aaloraini/portable-vending-machine/hardware/electronics/Electronics Sch.png

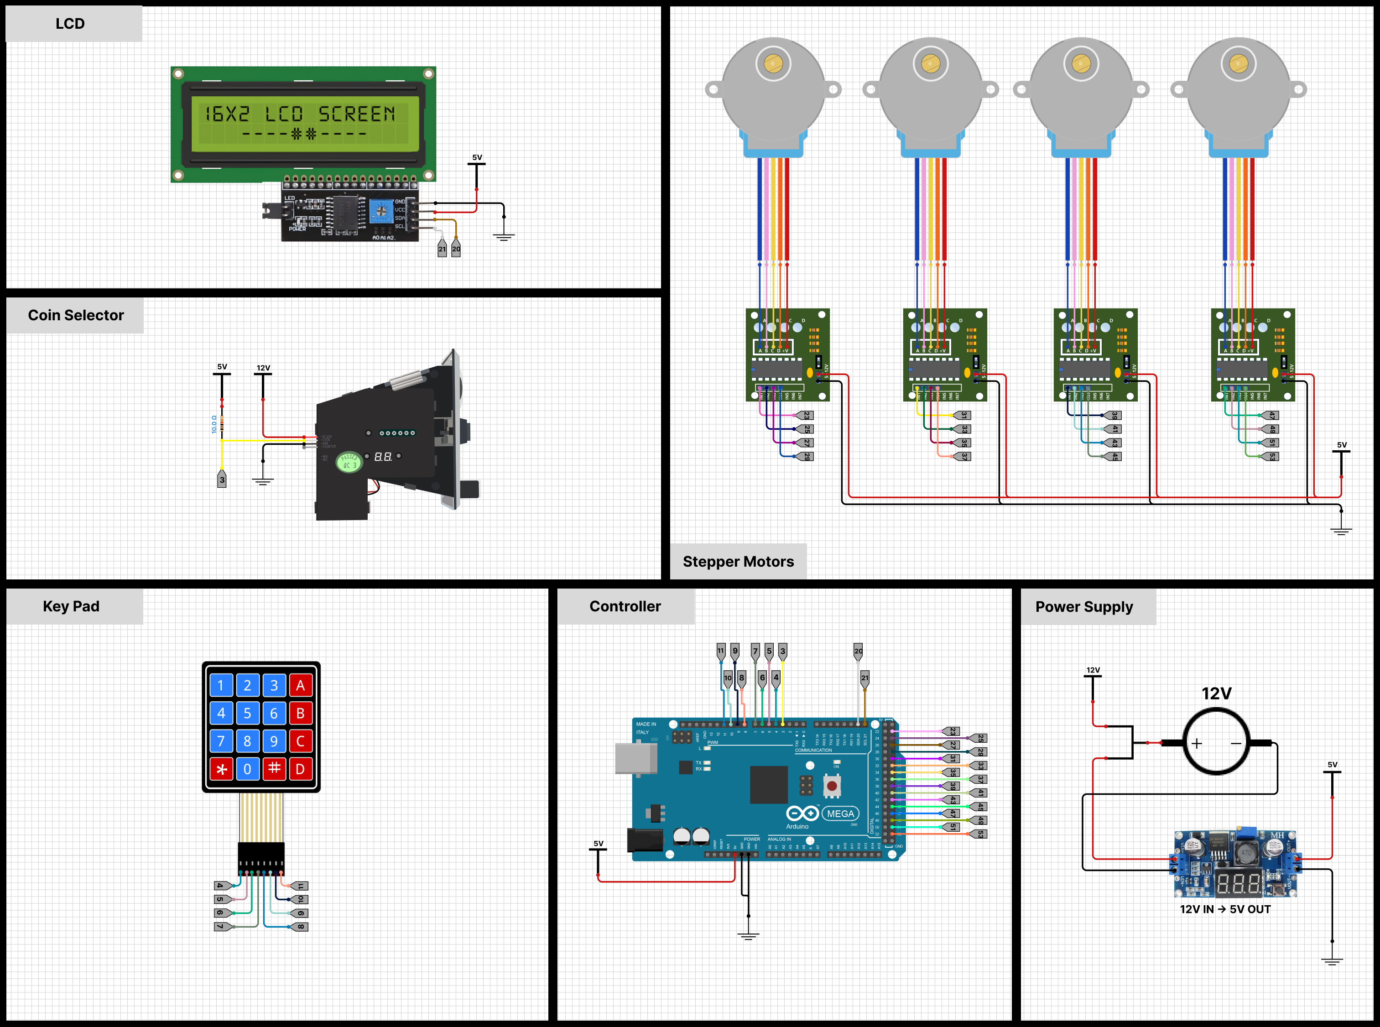
hardware/electronics/Electronics Sch.png
