aaloraini/portable-vending-machine/hardware/electronics/Demo BOM.xlsx

Product Name | X | Y | Z | DataSheet
Arduino Mega 2560 Rev3 | 100.5mm | 53mm | 14.05mm | Arduino Mega 2560 Rev3 (https://docs.arduino.cc/resources/datasheets/A000067-datasheet.pdf)
LCD Display (1602A QAPASS) | 80+-0.5mm | 36+-0.5mm | 17+-0.5mm | LCD Display (1602A QAPASS) (https://funduino.de/DL/1602LCD.pdf)
(1602A QAPASS) Front Display | 71+-0.5mm | 24+-0.5mm | 4.5+-0.5mm | LCD Display (1602A QAPASS) (https://funduino.de/DL/1602LCD.pdf)
Full Sized breadboard | 170mm | 55mm | 10mm | Breadboard (https://media.digikey.com/pdf/Data%20Sheets/Adafruit%20PDFs/239_Web.pdf)
(28BYJ-48 ) Stepper mototr | 28mm | 31mm | 29+-0.5mm | (28BYJ-48 ) Stepper mototr (https://www.gentiam.com/wp-content/uploads/2022/09/GentiamElectronics-28BYJ-48-Stepper-Motor-Datasheet-Rev20220925-final.pdf)
ULN2003 Driver | 35mm | 32.5mm | 13mm | ULN2003 Driver (https://www.hadex.cz/spec/m513.pdf)
Keypad | 69mm | 76mm | __ | Keypad (https://cdn.sparkfun.com/assets/f/f/a/5/0/DS-16038.pdf)
Keypad Cable | 20mm | 88mm | __ | Keypad (https://cdn.sparkfun.com/assets/f/f/a/5/0/DS-16038.pdf)
SW616 Coin Acceptor | 64mm | 124mm | 143mm | SW616 Coin Acceptor (https://probots.co.in/technical_data/Probots616CoinAcceptorModuleDatasheet.pdf)
