aaloraini/portable-vending-machine/hardware/cad/Vending Machine Layouts.pdf

297

297

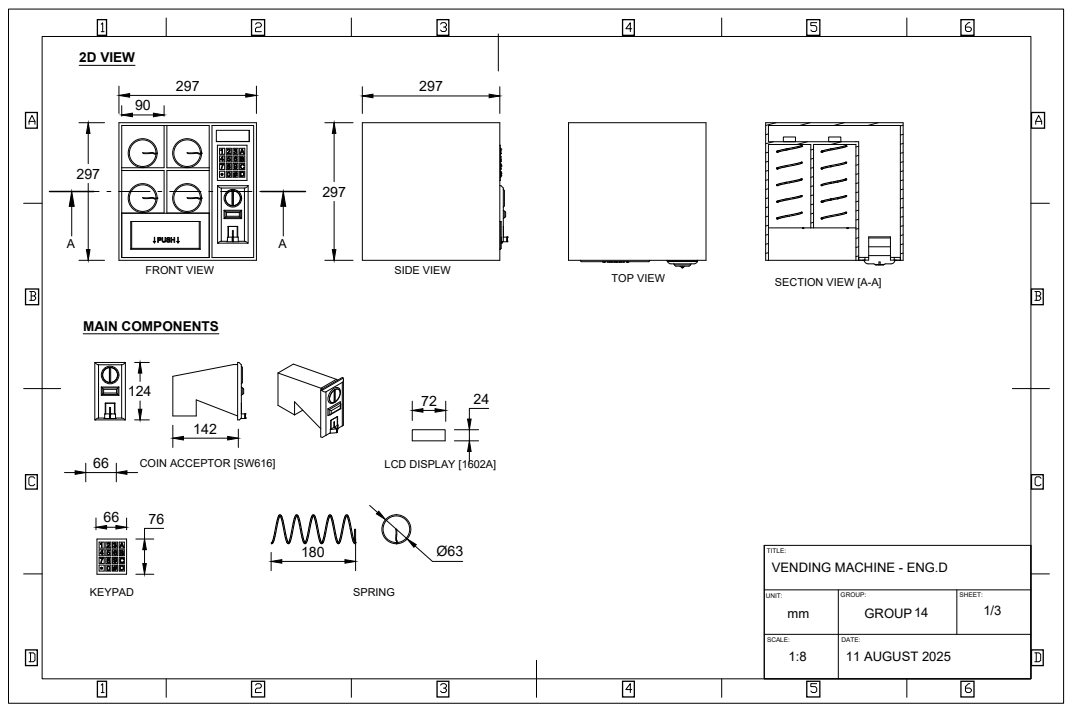
[picture p2: page 1]
FRONT VIEW; SIDE VIEW; TOP VIEW; 2D VIEW; MAIN COMPONENTS; COIN ACCEPTOR [SW616]; KEYPAD; SPRING; LCD DISPLAY [1602A]; UNIT:; SCALE: 1:8; GROUP: GROUP14; DATE: 11 AUGUST 2025; SHEET:; SECTION VIEW [A-A]

TITLE:
VENDING MACHINE - ENG.D

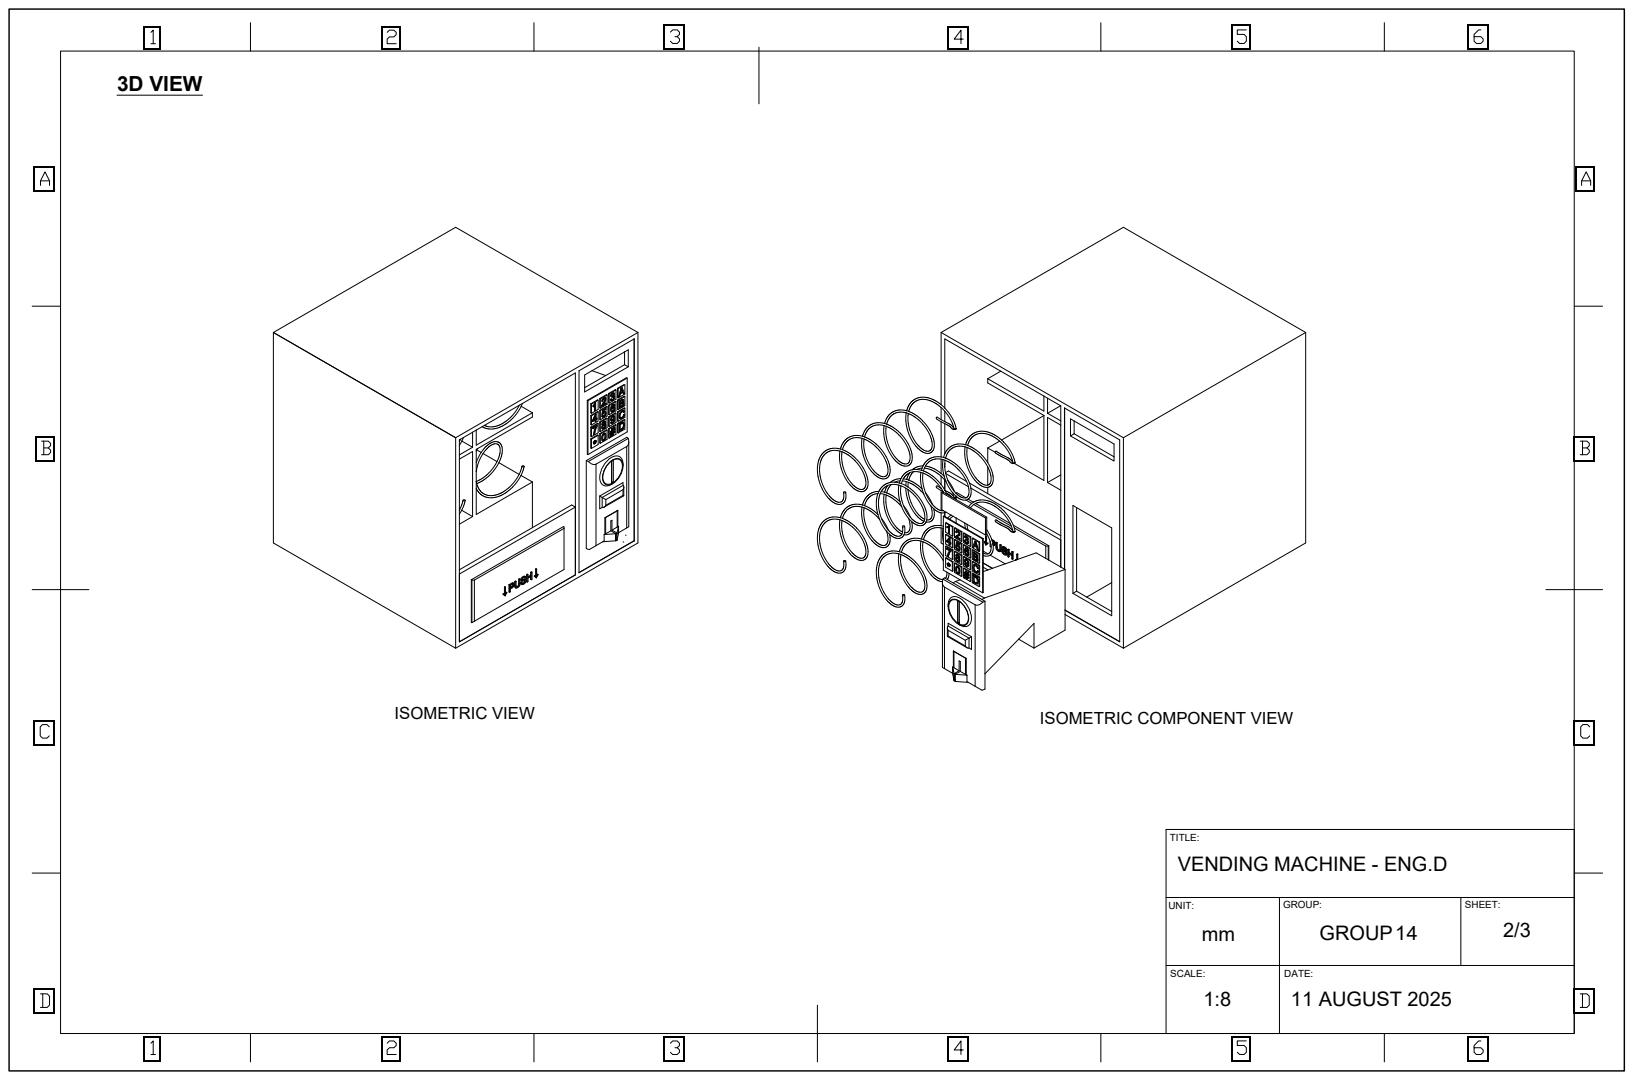
[picture p3: page 2]
3D VIEW; ISOMETRIC VIEW; ISOMETRIC COMPONENT VIEW; UNIT:; SCALE: 1:8; GROUP: GROUP14; DATE: 11 AUGUST 2025; SHEET:

TITLE:
VENDING MACHINE - ENG.D

285

297

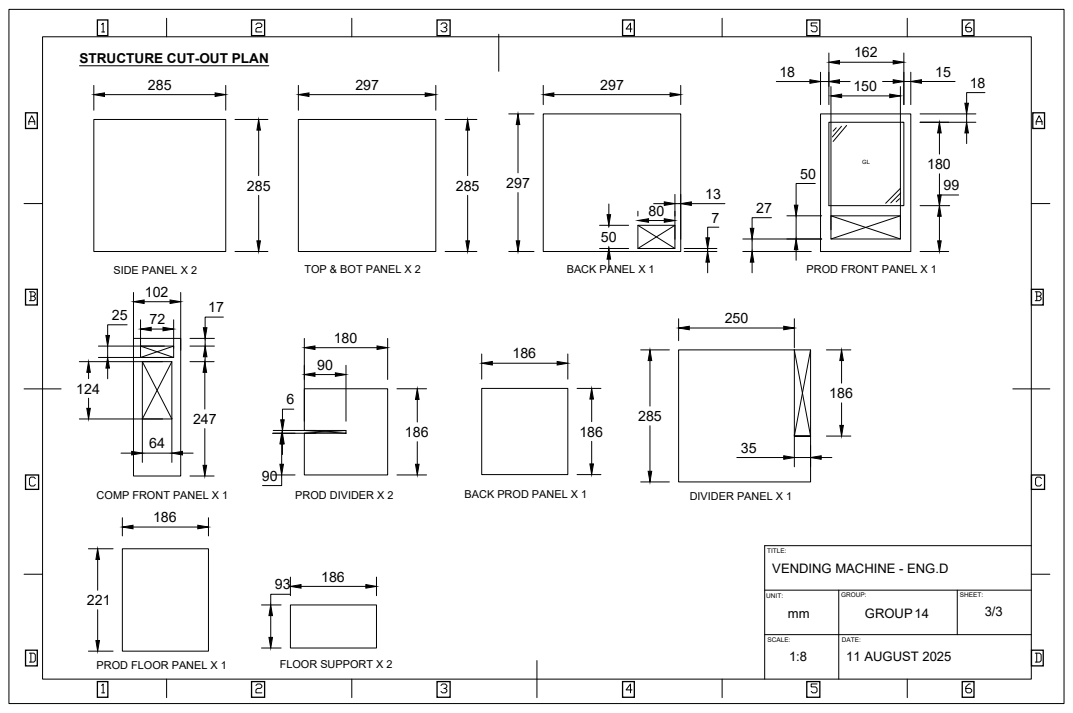
[picture p4: page 3]
SIDE PANEL X 2; BACK PANEL X 1; PROD DIVIDER X 2; DIVIDER PANEL X 1; FLOOR SUPPORT X 2; UNIT:; SCALE: 1:8; GROUP: GROUP14; DATE: 11 AUGUST 2025; SHEET:

STRUCTURE CUT-OUT PLAN

TOP & BOT PANEL X 2

PROD FRONT PANEL X 1

COMP FRONT PANEL X 1

BACK PROD PANEL X 1

TITLE:
VENDING MACHINE - ENG.D

PROD FLOOR PANEL X 1
