aaloraini/portable-vending-machine/logic/machine-logic.pdf

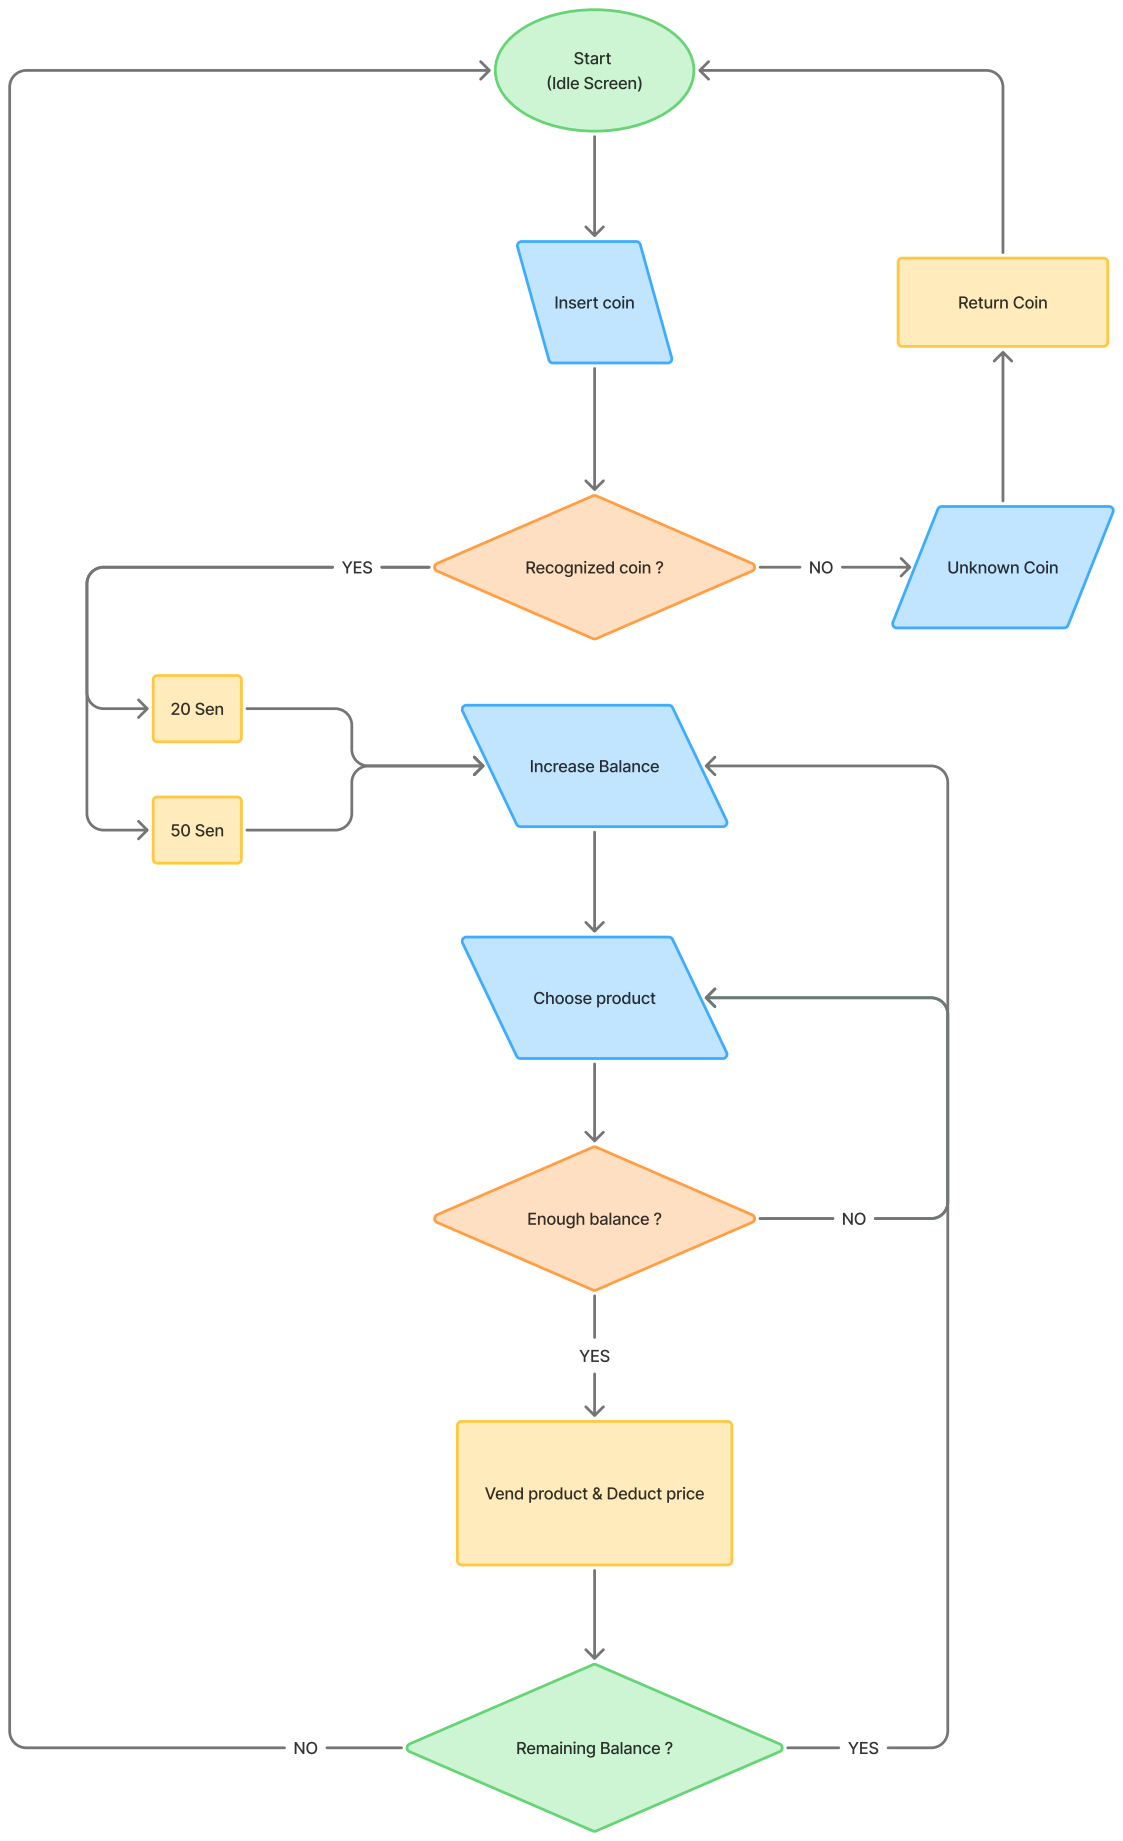
[picture p5: page 1]
Start; (Idle Screen); Insert coin; Recognized coin ?; Unknown Coin; 20 Sen; 50 Sen; Return Coin; YES; Increase Balance; Choose product; Enough balance ?; Remaining Balance ?

Vend product & Deduct price
